GliaX/compression-lever-bandage/Media/5lb_closed.png

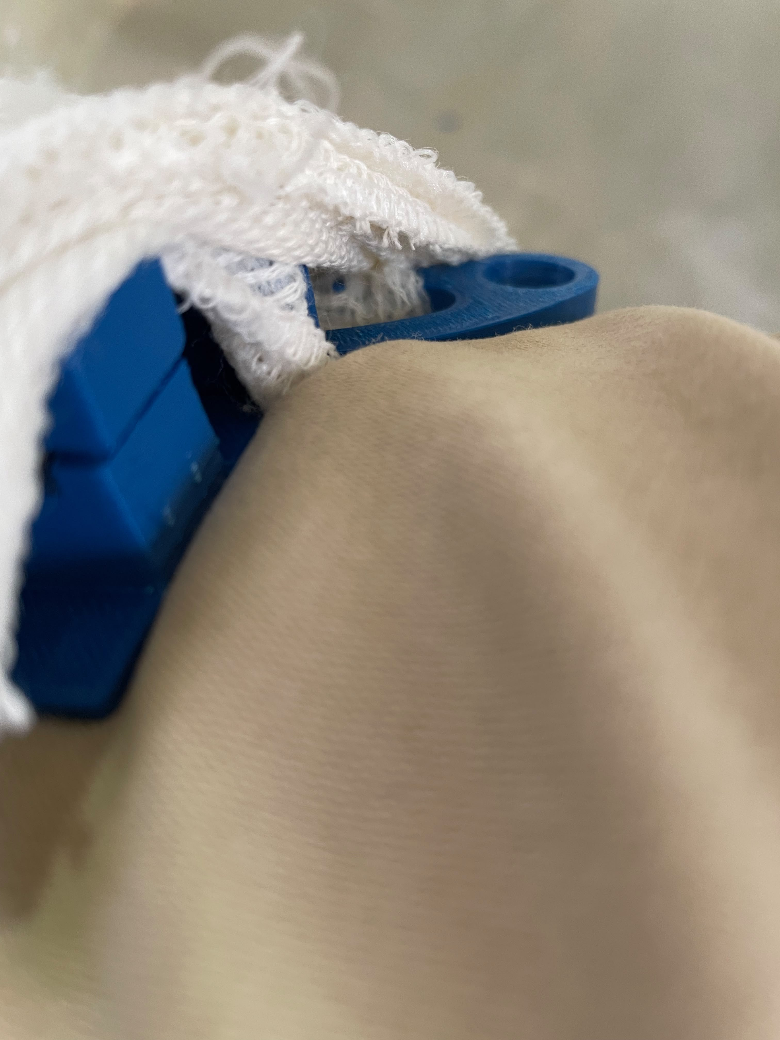
Media/5lb_closed.png
