GliaX/compression-lever-bandage/Media/5lb_design.png

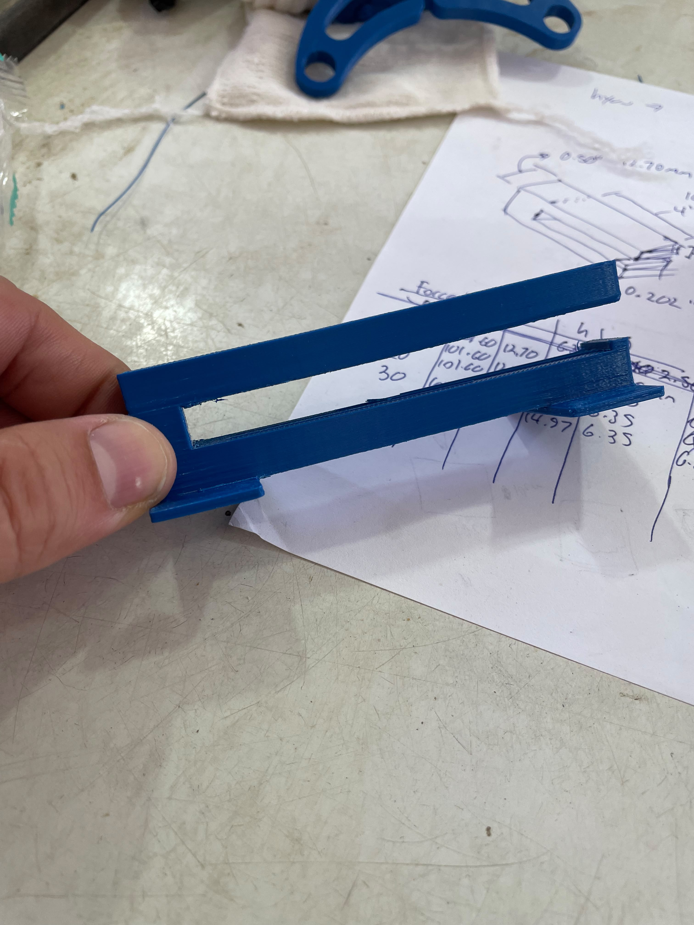
Media/5lb_design.png
