GliaX/compression-lever-bandage/Media/backplate_placement.jpeg

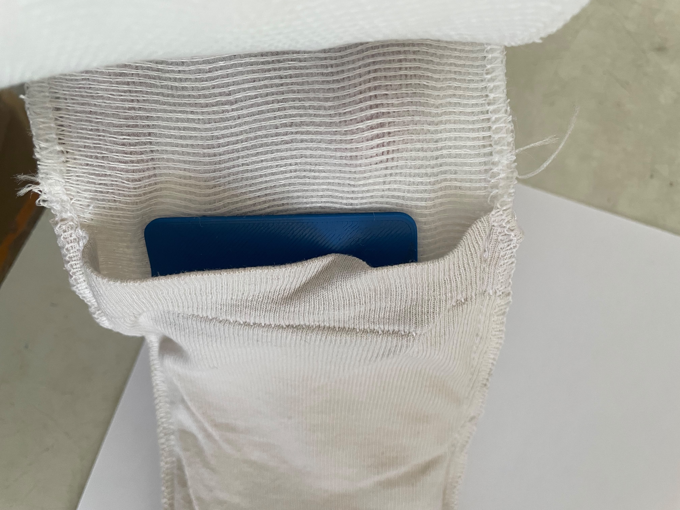
Media/backplate_placement.jpeg
