GliaX/compression-lever-bandage/Media/bandage_sewing_specs.png

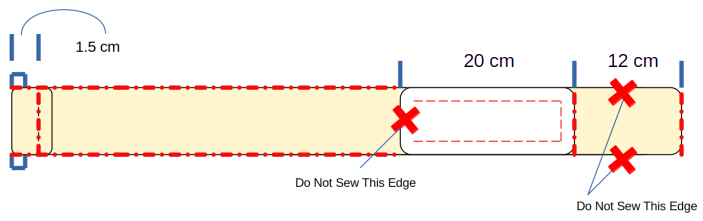
Media/bandage_sewing_specs.png
