GliaX/compression-lever-bandage/Media/lever_4pin_with_retainers.jpg

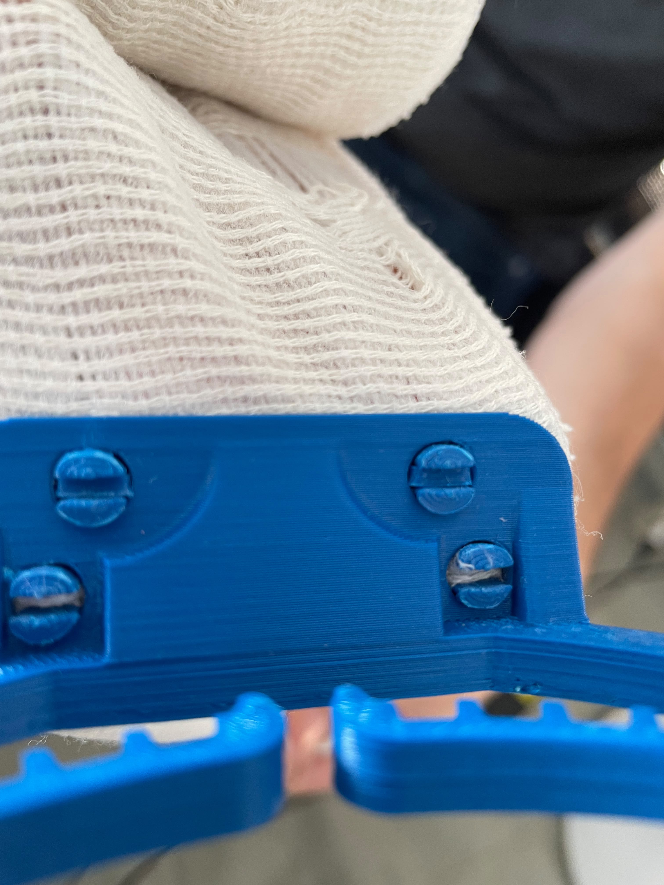
Media/lever_4pin_with_retainers.jpg
