GliaX/compression-lever-bandage/Media/Sewn_gauze.png

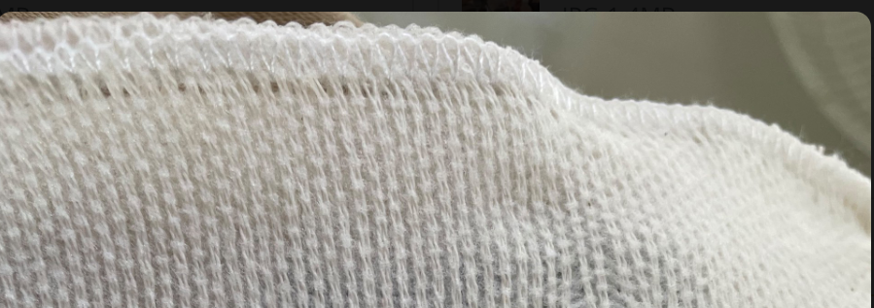
Media/Sewn_gauze.png
