GliaX/compression-lever-bandage/Media/bandage_material.jpg

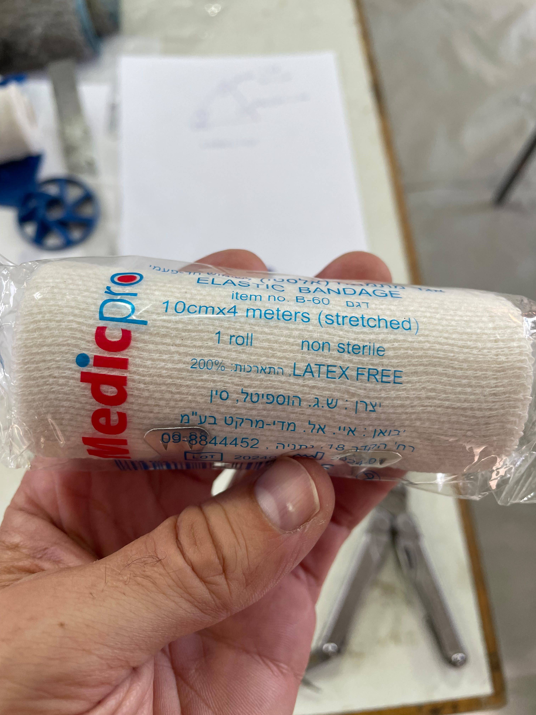
Media/bandage_material.jpg
