GliaX/compression-lever-bandage/CAD&STL/Clip.FCStd

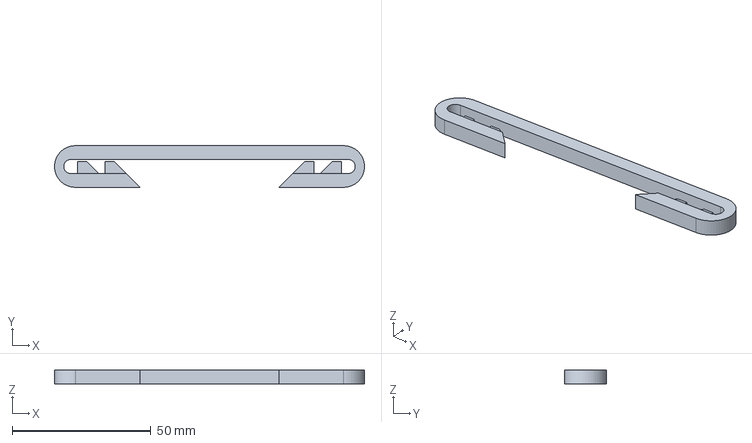
[picture p9: CAD file, 2026-10-29]
CAD&STL/Clip.FCStd
111.7 x 15.0 x 5.00 mm
