GliaX/compression-lever-bandage/CAD&STL/PinsWidge.FCStd

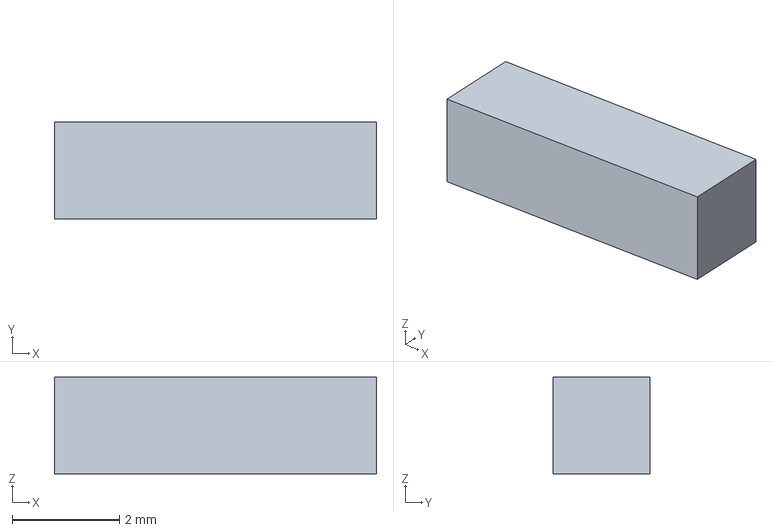
[picture p10: CAD file, 2026-10-29]
CAD&STL/PinsWidge.FCStd
6.00 x 1.80 x 1.80 mm
