GliaX/compression-lever-bandage/CAD&STL/emergency_compression_pins_v4-Body.stl

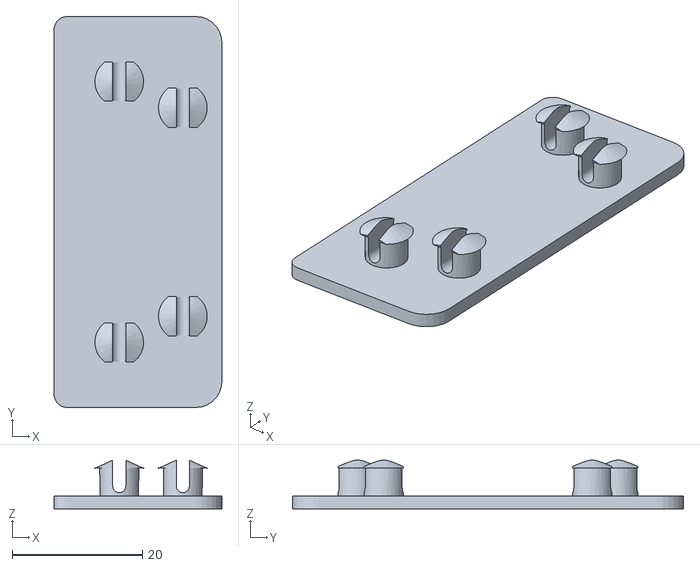
[picture p11: CAD file, 2026-10-29]
CAD&STL/emergency_compression_pins_v4-Body.stl
25.8 x 60.0 x 7.50
