GliaX/compression-lever-bandage/CAD&STL/emergency_compression_lever_v4.FCStd

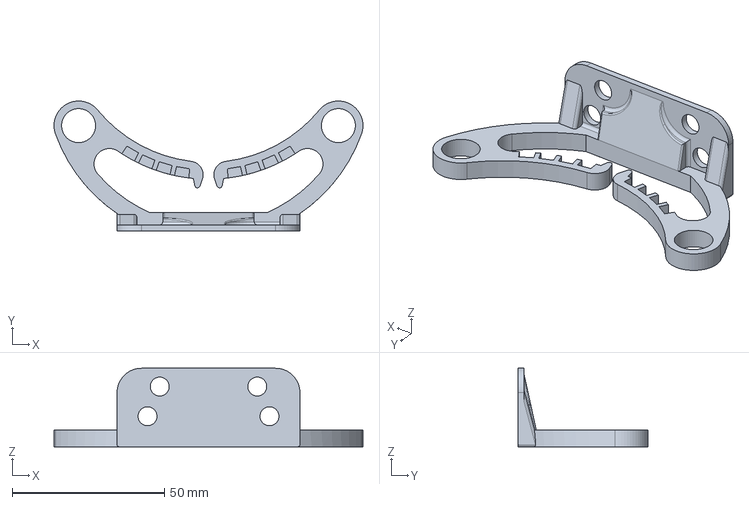
[picture p12: CAD file, 2026-10-29]
CAD&STL/emergency_compression_lever_v4.FCStd
101.4 x 42.6 x 25.8 mm
