GliaX/compression-lever-bandage/(list of files, cad)

Other CAD files:
CAD&STL/emergency_compression_lever_v4-Body.stl
CAD&STL/PinsWidge-Body.stl
CAD&STL/emergency_compression_pins_v4.FCStd
CAD&STL/Clip-ECL_end_clip.stl
