GliaX/compression-lever-bandage/Media/fully_assembled_lever.jpeg

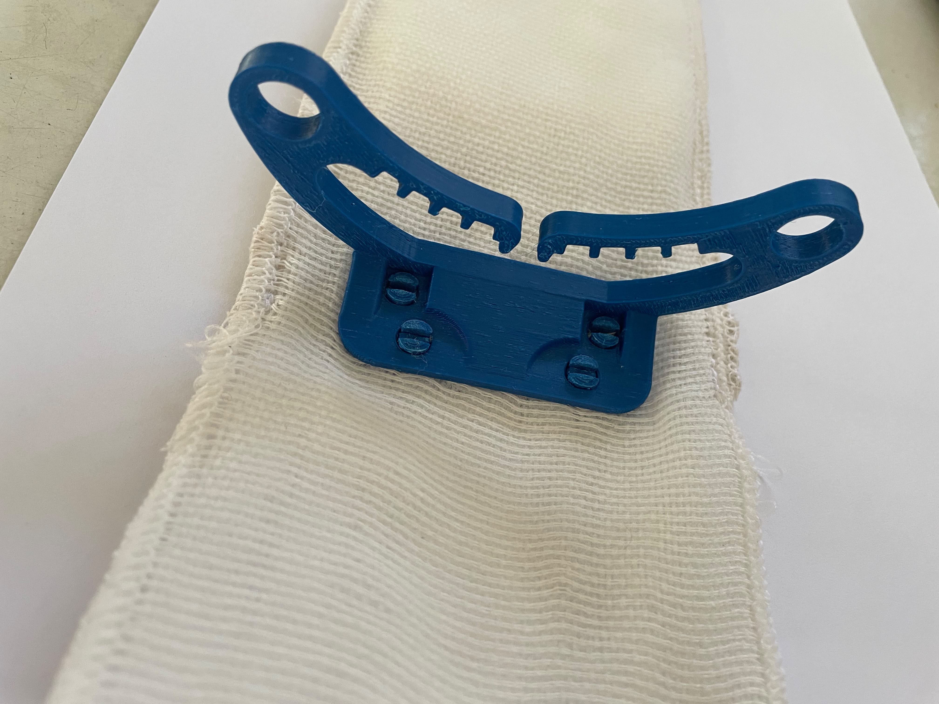
Media/fully_assembled_lever.jpeg
